pepaslabs/basic-lm399/README.md

# basic-lm399
A very basic LM399 voltage reference board design.

See the notes about the [latest release](kicad/releases/v1/README.md).

See also [svenskelektronik's fork](https://github.com/svenskelektronik/basic-lm399), which updates this project for the modern releases of KiCAD.
