pepaslabs/basic-lm399/kicad/releases/v1/bottom.png

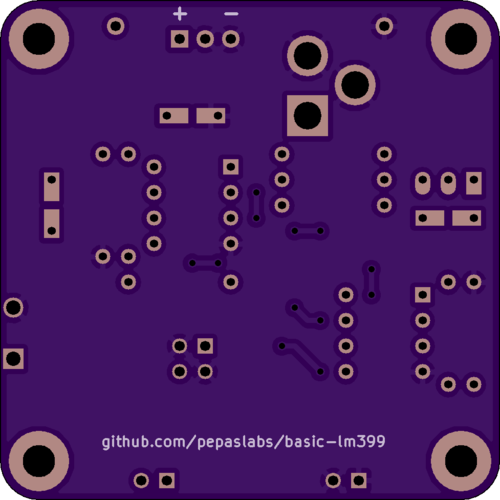
kicad/releases/v1/bottom.png
