pepaslabs/basic-lm399/kicad/releases/v1/bottom_copper.png

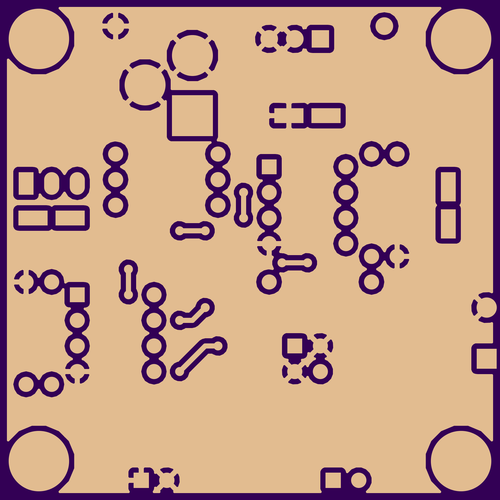
kicad/releases/v1/bottom_copper.png
