pepaslabs/basic-lm399/kicad/releases/v1/media/IMG_2575.JPG

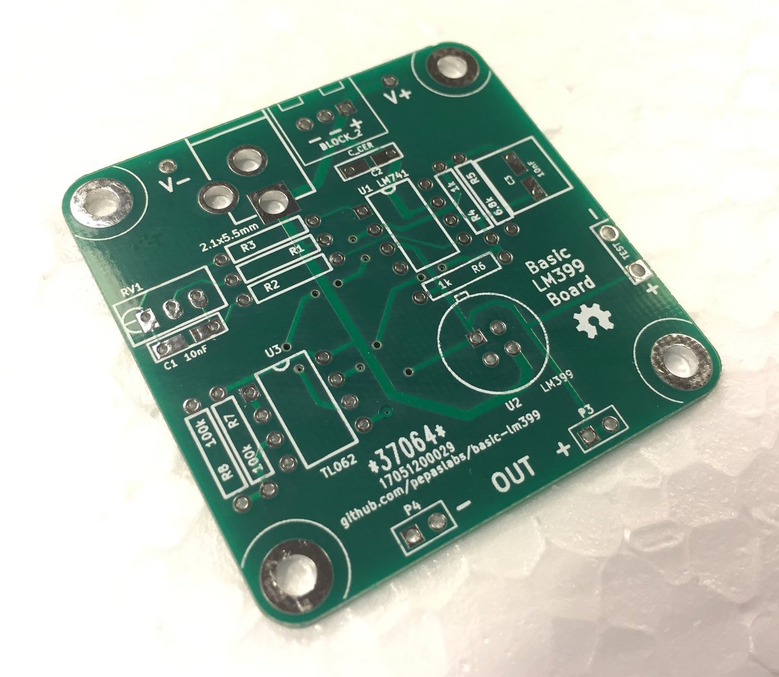
kicad/releases/v1/media/IMG_2575.JPG
