pepaslabs/basic-lm399/kicad/releases/v1/media/IMG_2576.JPG

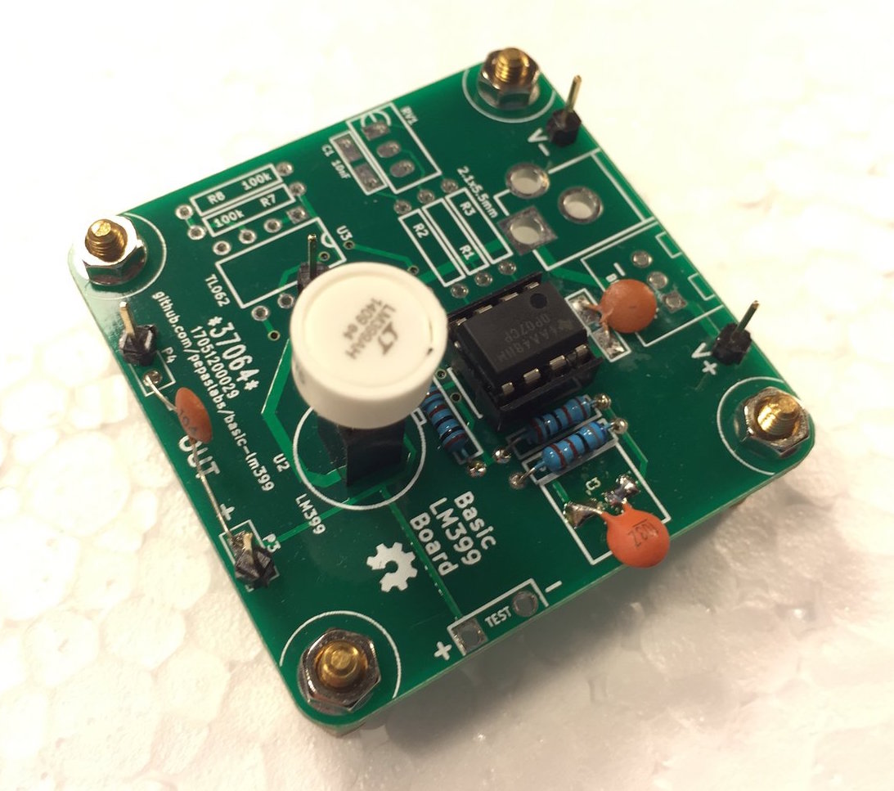
kicad/releases/v1/media/IMG_2576.JPG
