pepaslabs/basic-lm399/kicad/releases/v1/top.png

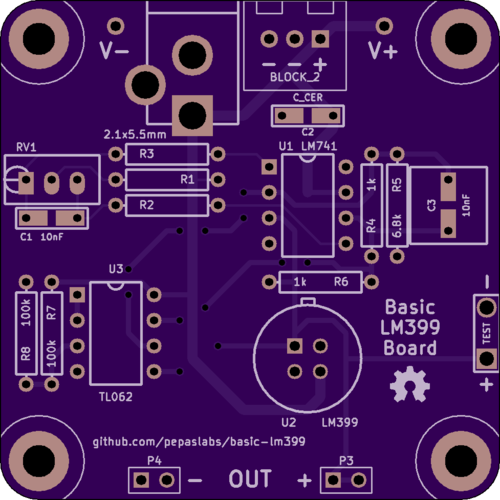
kicad/releases/v1/top.png
