pepaslabs/basic-lm399/kicad/releases/v1/top_copper.png

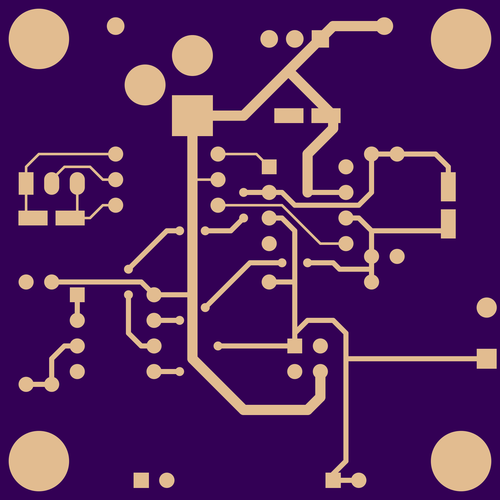
kicad/releases/v1/top_copper.png
