pepaslabs/basic-lm399/kicad/releases/v1/top_silk.png

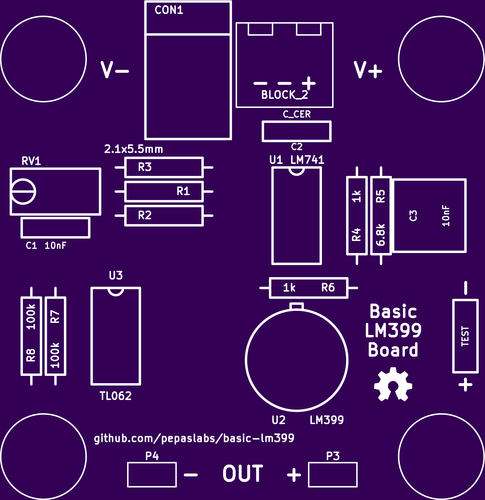
kicad/releases/v1/top_silk.png
