pepaslabs/basic-lm399/kicad/releases/v1/trivial-lm399.pdf

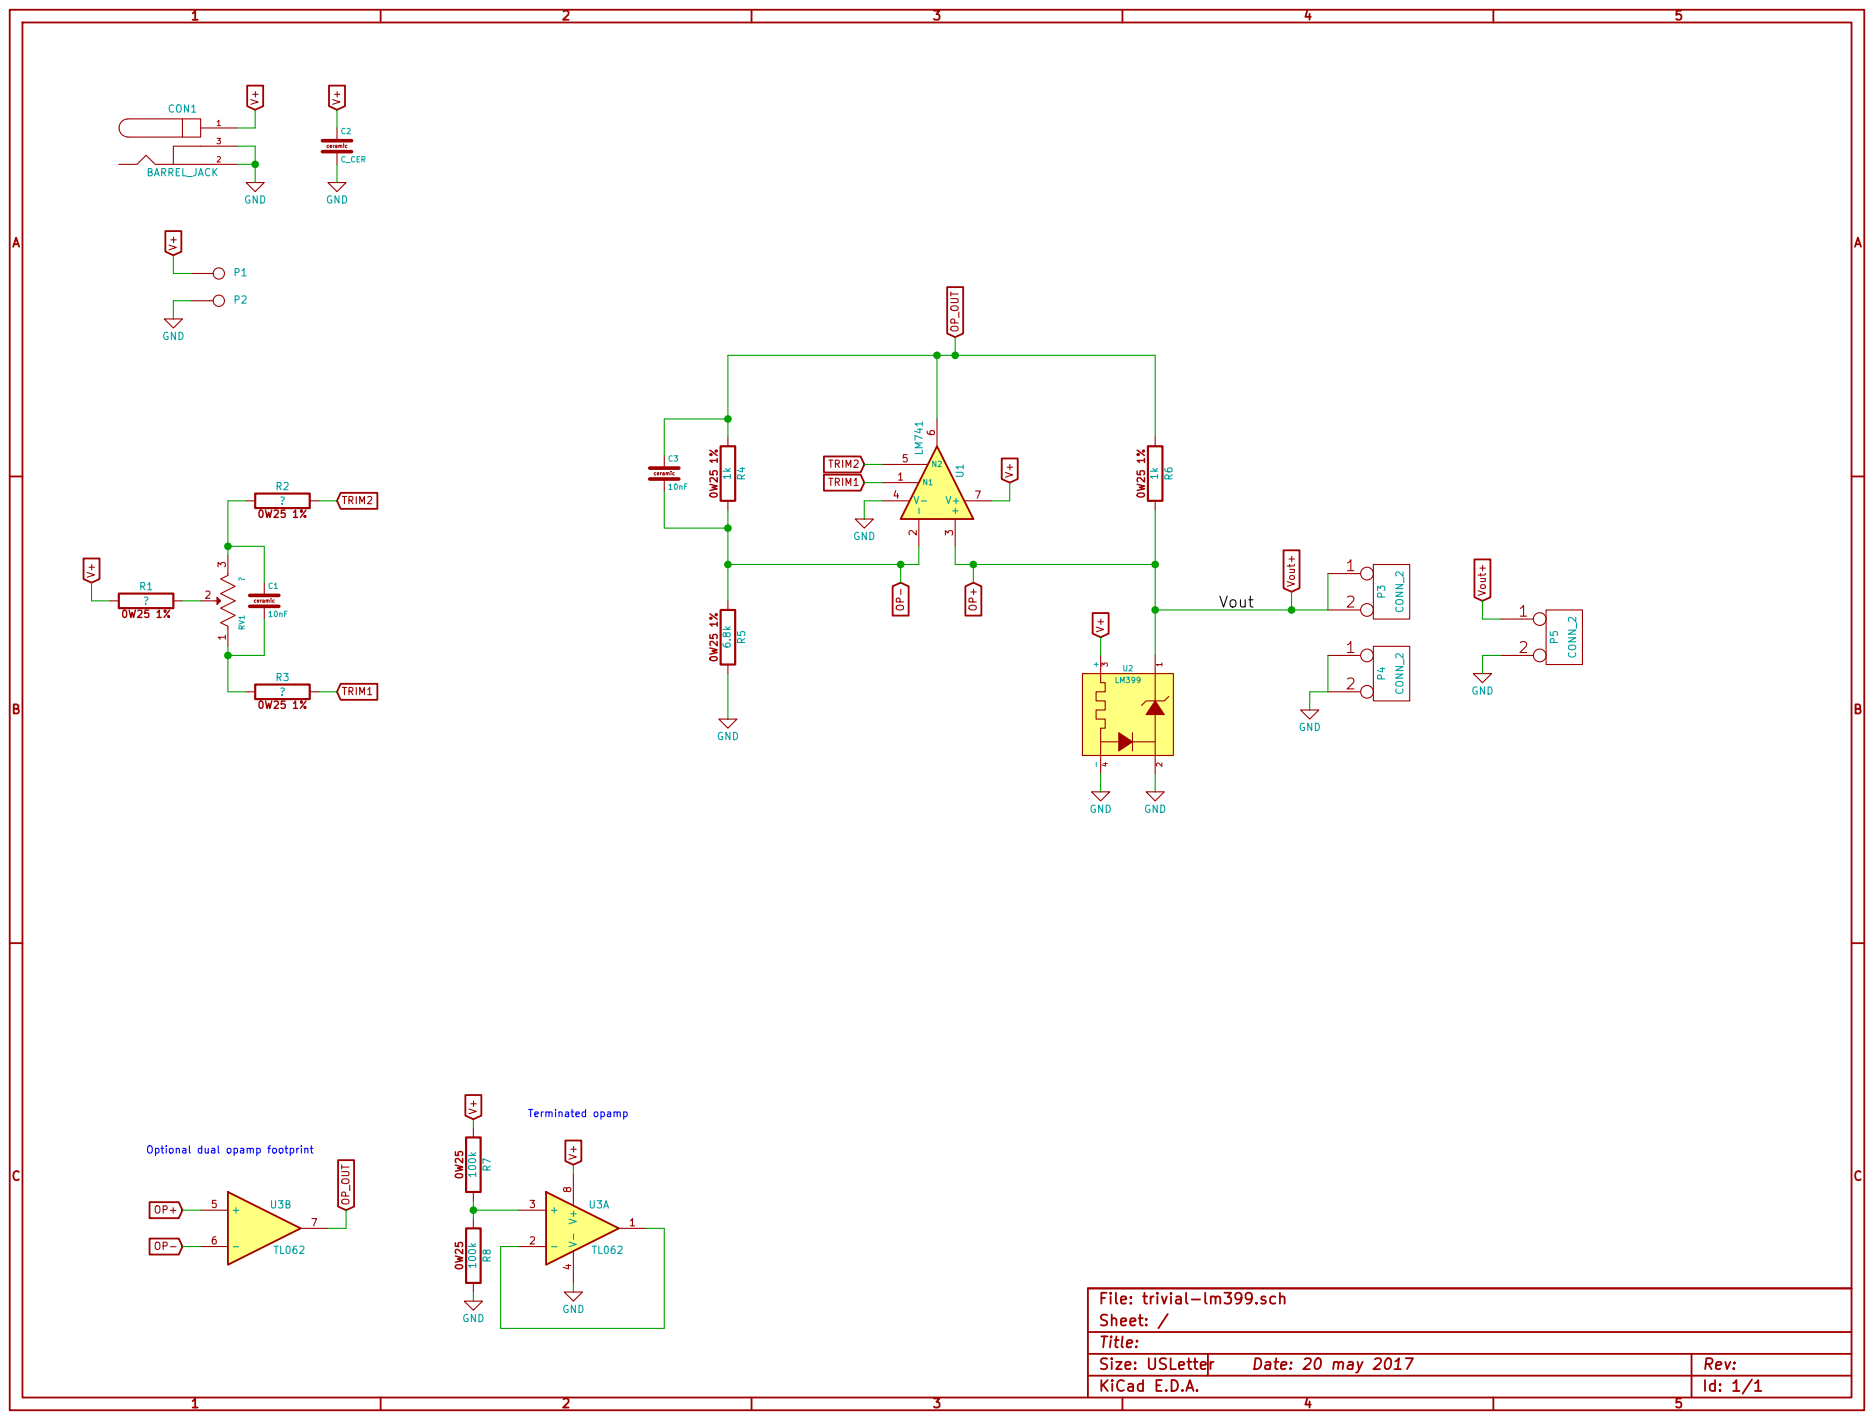
[picture p14: page 1]

6 V+ 7 U1 LM741 0W25 1% 1kR6 0W25 1% 1kR4 0W25 1% R5 6.8k GND GND GND V+ V+ GND

Id: 1/1 Title: File: trivial-lm399.sch Sheet: /
