pepaslabs/basic-lm399/kicad/trivial-lm399.kicad_pcb

## KiCad design kicad/trivial-lm399.kicad_pcb (2018-03-23)

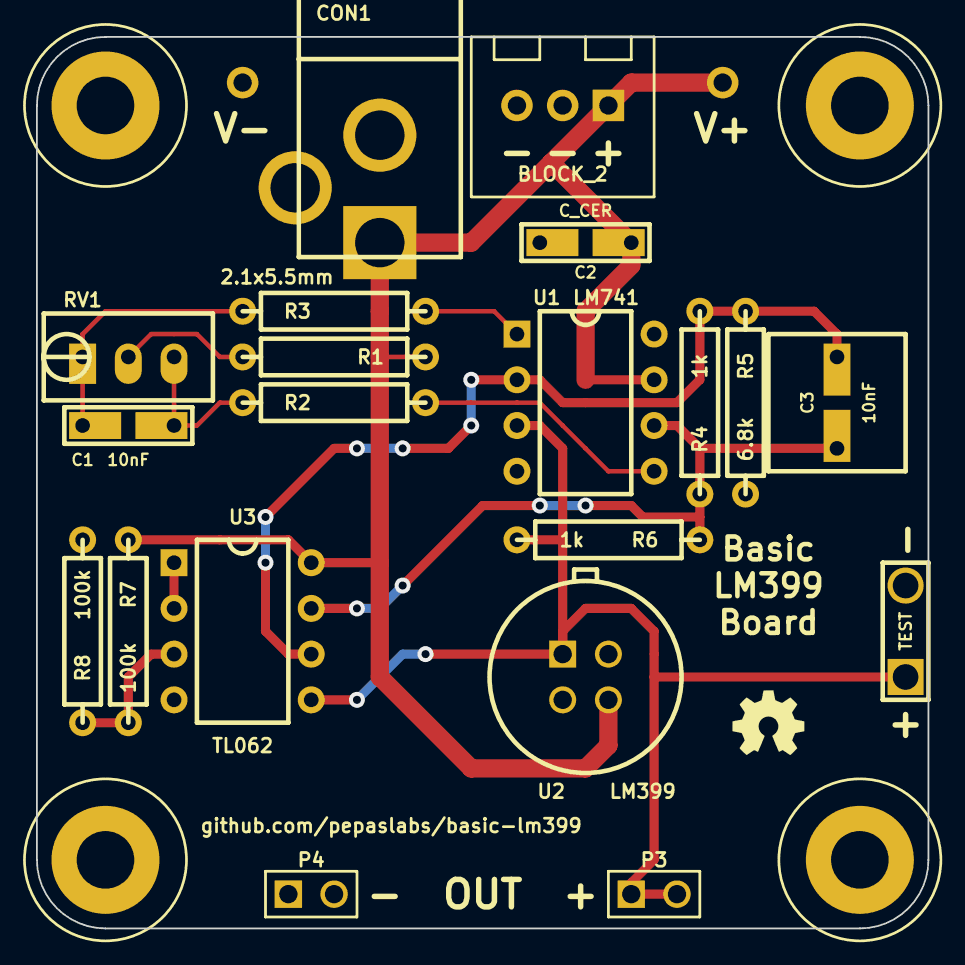
[picture p15: board trivial-lm399.kicad_pcb from above]

Board: 2 copper layers, 49.5 x 49.5 mm, 26 parts (0 on the bottom side), 12 nets.

Parts:
BLOCK_2: Val**; TERMINAL_BLOCK_2_5mm
C1: 10nF; CERCAP_2_059B_0805
C2: C_CER; CERCAP_2_059B_0805
C3: 10nF; ANYSSCAP_2_059B_0805
CON1: BARREL_JACK; BARREL_JACK_21x55
H***: Val**; hole_M3
H***#2, H***#3, H***#4: Val**; hole_M3
P1, P2: CONN_1; 1pin_040_069
P3, P4: CONN_2; PIN_ARRAY_2X1
R1, R2, R3: ?; R_AXIAL_0W25_059A_PL
R4, R6: 1k; R_AXIAL_0W25_059A_PL
R5: 6.8k; R_AXIAL_0W25_059A_PL
R7, R8: 100k; R_AXIAL_0W25_059A_PL
RV1: ?; 3296W_PL
TEST: CONN_2; TEST_2
U1: LM741; DIP8_059A_PL
U2: LM399; TO-46-PLASTIC
U3: TL062; DIP8_059A_PL

Connections:
GND: BLOCK_2.2, C2.2, CON1.2, CON1.3, P2.1, P4.1, P4.2, R5.2, R8.2, TEST.2, U1.4, U2.2, U2.4, U3.4
unnamed: R1.2, RV1.2
unnamed: U3.1, U3.2
unnamed: R7.2, R8.1, U3.3
unnamed: C1.1, R2.1, RV1.3
unnamed: C1.2, R3.1, RV1.1
OP+: P3.1, P3.2, R6.2, TEST.1, U1.3, U2.1, U3.5
OP-: C3.2, R4.2, R5.1, U1.2, U3.6
OP_OUT: C3.1, R4.1, R6.1, U1.6, U3.7
TRIM1: R3.2, U1.1
TRIM2: R2.2, U1.5
V+: BLOCK_2.1, C2.1, CON1.1, P1.1, R1.1, R7.1, U1.7, U2.3, U3.8
