pepaslabs/basic-lm399/(commit log)

2018-03-23 initial release
    [basic-lm399.kicad_pcb, basic-lm399.sch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]
2018-03-23 rolling back to version which matches boards
    [trivial-lm399.kicad_pcb, trivial-lm399.sch]
2018-03-23 schematic pngs
2018-03-23 board renders
